Dantespino4D/Robot-sumo/PCBs/inferior/docs/inferior-PNG.png

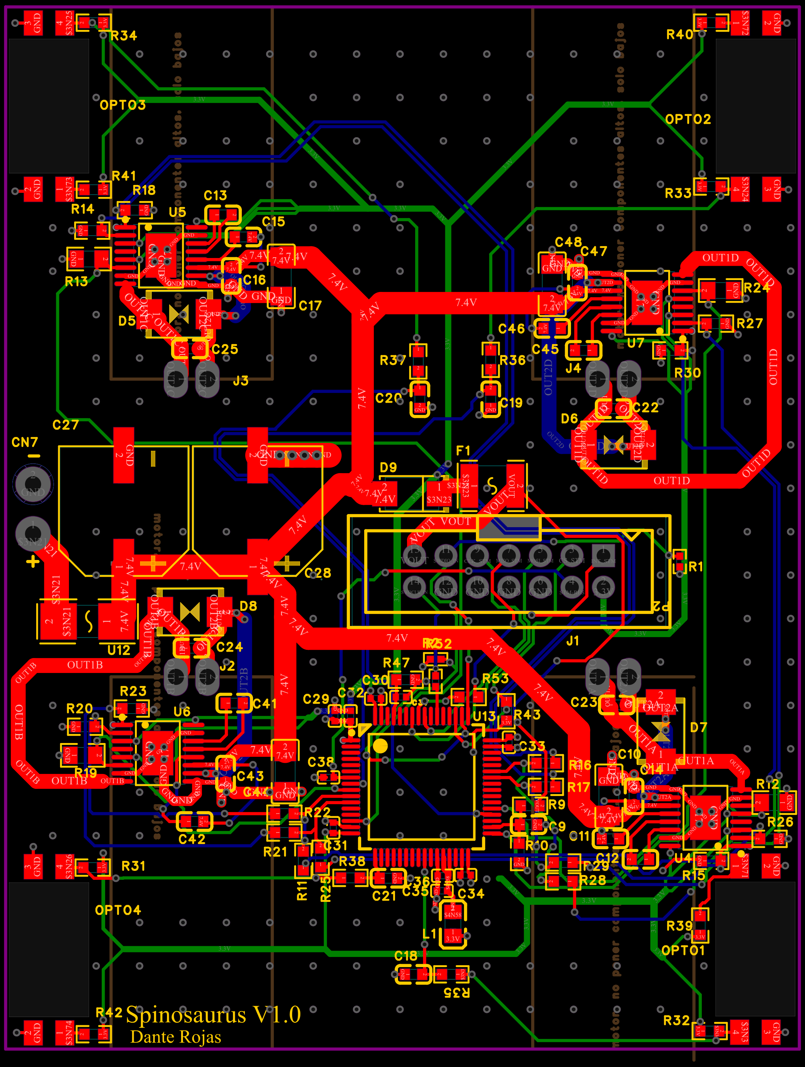
PCBs/inferior/docs/inferior-PNG.png
