Dantespino4D/Robot-sumo/PCBs/superior/docs/superior-PNG.png

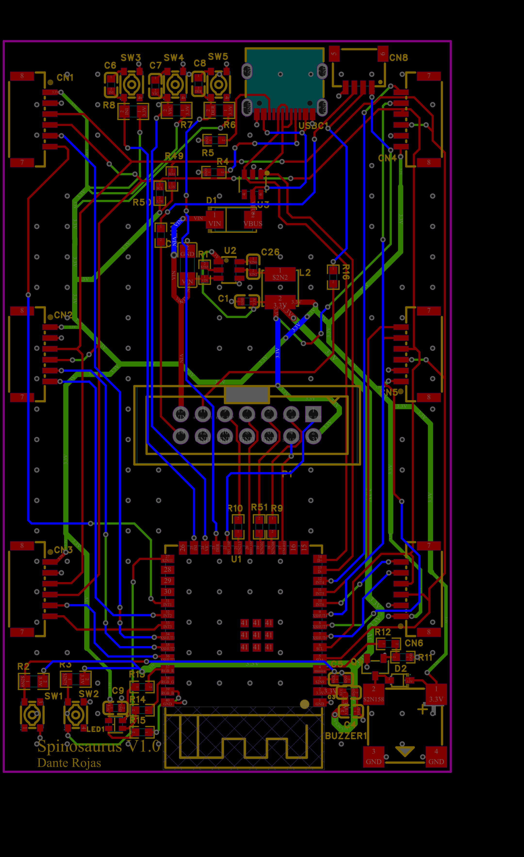
PCBs/superior/docs/superior-PNG.png
