Dantespino4D/Robot-sumo/PCBs/inferior/assembly/inferior-BOM.csv

No. | Quantity | Comment | Designator | Footprint | Value | Manufacturer Part | Manufacturer | Supplier Part | Supplier
1 | 13 | 100nF | C9,C11,C14,C15,C16,C22,C23,C24,C25,C42,C43,C46,C47 | C0603 |  | CC0603KRX7R9BB104 | YAGEO(国巨) | C14663 | LCSC
2 | 4 | 10uF | C10,C17,C44,C48 | C1206 |  | CL31B106KBHNNNE | SAMSUNG(三星) | C89632 | LCSC
3 | 4 | 47nF | C12,C13,C41,C45 | C0603 | 47nF | CL10B473KB8NNNC | SAMSUNG(三星) | C1622 | LCSC
4 | 4 | 10nF | C18,C19,C20,C21 | C0603 |  | 0603B103K500NT | FH(风华) | C57112 | LCSC
5 | 2 | 330uF | C27,C28 | CAP-SMD_BD10.0-L10.3-W10.3-LS11.0-FD |  | 25SVPF330M | PANASONIC(松下) | C48970627 | LCSC
6 | 1 | 4.7uF | C29 | C0402 | 4.7uF | CL05A475MP5NRNC | SAMSUNG(三星) | C23733 | LCSC
7 | 7 | 100nF | C30,C31,C32,C33,C34,C37,C38 | C0402 | 100nF | CL05B104KO5NNNC | SAMSUNG(三星) | C1525 | LCSC
8 | 1 | 1uF | C35 | C0402 | 1uF | CL05A105KA5NQNC | SAMSUNG(三星) | C52923 | LCSC
9 | 1 | 10nF | C36 | C0402 | 10nF | CL05B103KB5NNNC | SAMSUNG(三星) | C15195 | LCSC
10 | 1 | VH2-HEADER2 | CN7 | BAT_PIGTAIL_PADS_20AWG |  | VH2-Header2 | null | C9900011009 | LCSC
11 | 4 | SM6T15CA | D5,D6,D7,D8 | SMB_L4.6-W3.6-LS5.3-BI |  | SM6T15CA | ST(意法半导体) | C435927 | LCSC
12 | 1 | SS34 | D9 | SMA_L4.3-W2.6-LS5.2-RD |  | SS34 | MDD(辰达半导体) | C8678 | LCSC
13 | 1 | MF-MSMF150/24X-2 | F1 | F1812 |  | MF-MSMF150/24X-2 | BOURNS | C78695 | LCSC
14 | 4 | DB128L-5.08-2P | J1,J2,J3,J4 | PAD_MOTOR_2P_STRAIN_RELIEF |  | DB128L-5.08-2P-GN-S | DORABO(地博电气) | C395868 | LCSC
15 | 1 | GZ2012D101TF | L1 | L0805 |  | GZ2012D101TF | Sunlord(顺络) | C1015 | LCSC
16 | 4 | TCRT5000_C3271803 | OPTO1,OPTO2,OPTO3,OPTO4 | OPTO-TH_TCRT5000 |  | TCRT5000 | VISHAY(威世) | C3271803 | LCSC
17 | 1 | 2.54-2*7P简牛 | P2 | IDC-TH_14P-P2.54-V-R2-C7-S2.54 |  | 2.54-2*7P简牛 | BOOMELE(博穆精密) | C11215 | LCSC
18 | 2 | 10kΩ | R1,R2 | R0402 | 10kΩ | 0402WGF1002TCE | UNI-ROYAL(厚声) | C25744 | LCSC
19 | 1 | 3.3kΩ | R9 | R0603 |  | 0603WAF3301T5E | UNI-ROYAL(厚声) | C22978 | LCSC
20 | 1 | 1.5kΩ | R10 | R0603 |  | 0603WAF1501T5E | UNI-ROYAL(厚声) | C22843 | LCSC
21 | 8 | 330Ω | R11,R16,R17,R21,R22,R25,R28,R29 | R0603 |  | 0603WAF3300T5E | UNI-ROYAL(厚声) | C23138 | LCSC
22 | 4 | 1kΩ | R12,R13,R19,R24 | R0805 |  | 0805W8F1001T5E | UNI-ROYAL(厚声) | C17513 | LCSC
23 | 14 | 10kΩ | R14,R15,R18,R20,R23,R26,R27,R30,R31,R32,R33,R34,R43,R47 | R0603 |  | 0603WAF1002T5E | UNI-ROYAL(厚声) | C25804 | LCSC
24 | 4 | 1kΩ | R35,R36,R37,R38 | R0603 |  | 0603WAF1001T5E | UNI-ROYAL(厚声) | C21190 | LCSC
25 | 4 | 100Ω | R39,R40,R41,R42 | R0603 |  | 0603WAF1000T5E | UNI-ROYAL(厚声) | C22775 | LCSC
26 | 1 | 330Ω | R52 | R0402 | 330Ω | 0402WGF3300TCE | UNI-ROYAL(厚声) | C25104 | LCSC
27 | 1 | 33Ω | R53 | R0603 |  | 0603WAF330JT5E | UNI-ROYAL(厚声) | C23140 | LCSC
28 | 4 | DRV8874PWPR | U4,U5,U6,U7 | HTSSOP-16_L5.0-W4.4-P0.65-LS6.4-BL-EP |  | DRV8874PWPR | TI(德州仪器) | C1855818 | LCSC
29 | 1 | 2410FA-10A | U12 | FUSE-SMD_L6.1-W2.6 |  | 2410FA-10A | prosemi(普罗森美) | C2838934 | LCSC
30 | 1 | STM32G474RET6 | U13 | LQFP-64_L10.0-W10.0-P0.50-LS12.0-BL |  | STM32G474RET6 | ST(意法半导体) | C521608 | LCSC
