Dantespino4D/Robot-sumo/carcasa/piezas/stl/baseIntermedia.stl

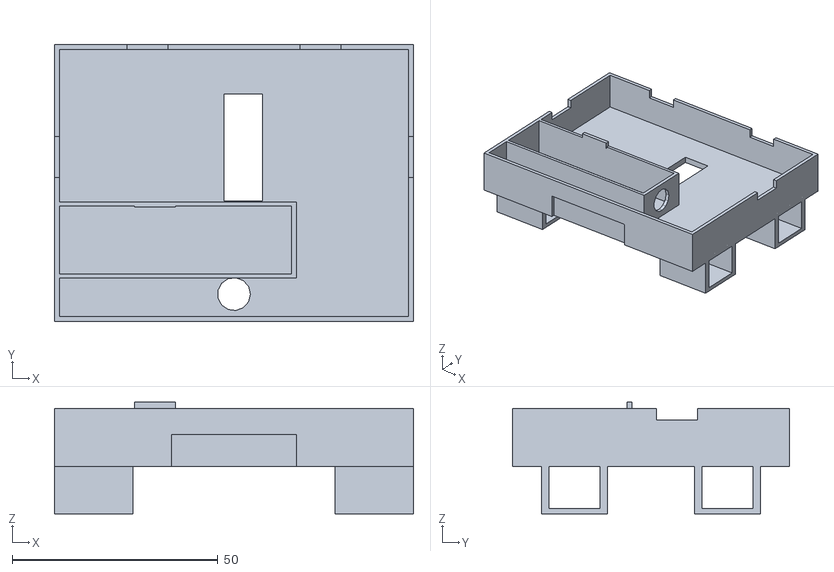
[picture p3: CAD file, 2026-11-11]
carcasa/piezas/stl/baseIntermedia.stl
87.2 x 67.2 x 27.1
