Dantespino4D/Robot-sumo/PCBs/inferior/3D/sumo-PCB-inferior.step

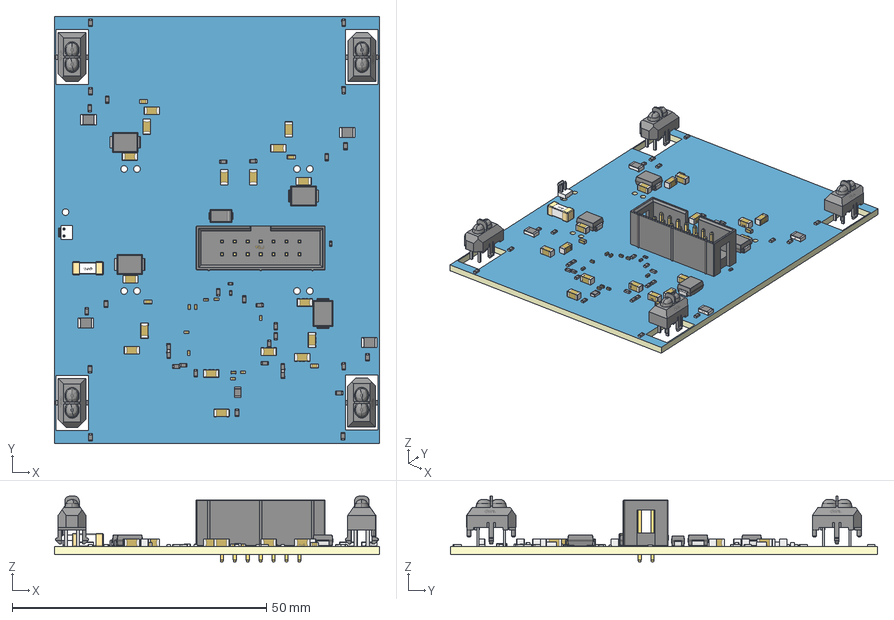
[picture p4: CAD file, 2026-10-07]
PCBs/inferior/3D/sumo-PCB-inferior.step
64.0 x 84.0 x 12.9 mm
Board~Igoe
TopCopper~Igoe
BottomCopper~Igoe
TopSilkscreen~Igoe
BottomSilkscreen~Igoe
TopFpcStiffener~Igoe
BottomFpcStiffener~Igoe
C0603~C0603~EXZm x 17
C0603~C0603_L1.6-W0.8-H0.8~EXZm x 4
R0603~R0603~OePm x 33
C0402~C0402_L1.0-W0.5-H0.5~cSQW x 10
R0402~R0402_L1.0-W0.5-H0.4~BnWU x 3
OPTO-TH_TCRT5000~OPTO-TH_TCRT5000~g6yf x 4
BAT_PIGTAIL_PADS_20AWG~CONN-TH_2P-P4.00_VH2-HEADER2~h32M
SMA_L4.3-W2.6-LS5.2-RD~SMA_L4.3-W2.6-LS5.2-RD~O7c9
IDC-TH_14P-P2.54-V-R2-C7-S2.54~IDC-TH_14P-P2.54-V-R2-C7-S2.54~8Vgt
R0805~R0805~fm0l x 4
L0805~R0805_L2.0-W1.3-H0.6~fm0l
SMB_L4.6-W3.6-LS5.3-BI~SMB_L4.6-W3.6-LS5.3-BI~sz2G x 4
FUSE-SMD_L6.1-W2.6~FUSE-SMD_L6.1-W2.6-H2.6~2nz7
