Dantespino4D/Robot-sumo/PCBs/superior/3D/sumo-PCB-superior.stl

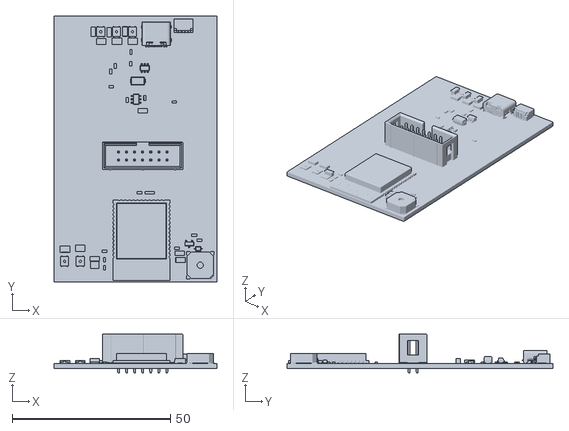
[picture p5: CAD file, 2026-11-07]
PCBs/superior/3D/sumo-PCB-superior.stl
51.4 x 84.0 x 12.2
