Dantespino4D/Robot-sumo/carcasa/piezas/stl/seguro.stl

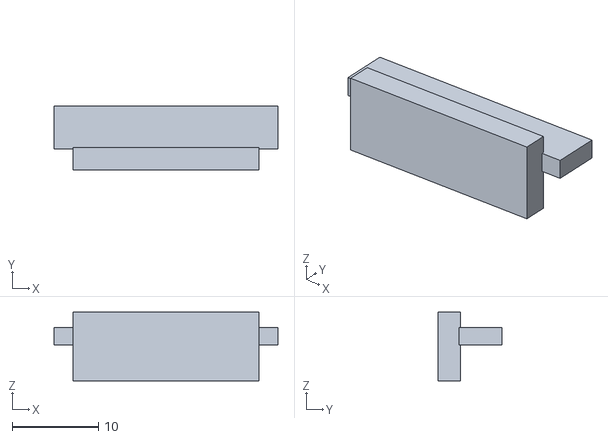
[picture p6: CAD file, 2026-11-11]
carcasa/piezas/stl/seguro.stl
26.0 x 7.40 x 8.00
