Dantespino4D/Robot-sumo/carcasa/piezas/stl/tapa.stl

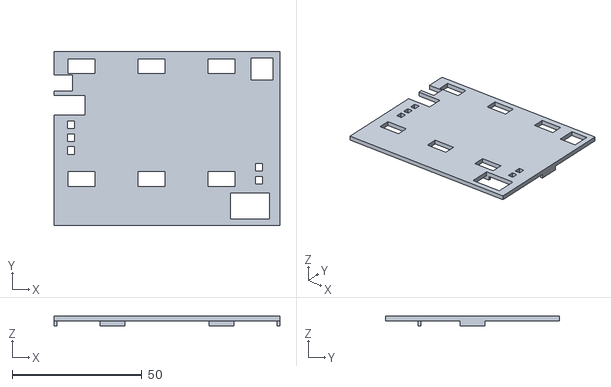
[picture p7: CAD file, 2026-11-11]
carcasa/piezas/stl/tapa.stl
87.2 x 67.2 x 3.90
