Dantespino4D/Robot-sumo/carcasa/piezas/stl/baseSuperior.stl

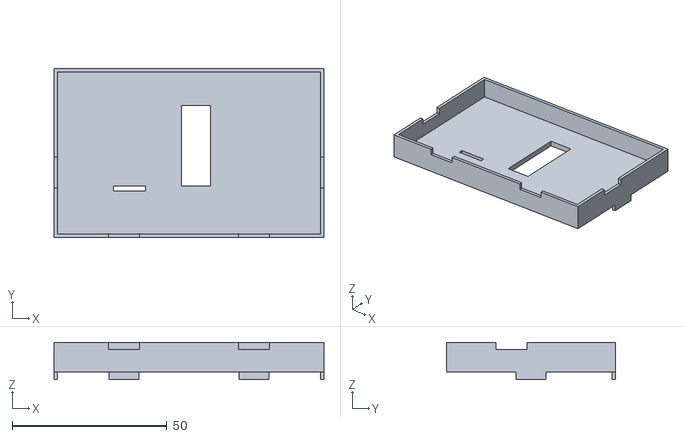
[picture p8: CAD file, 2026-11-11]
carcasa/piezas/stl/baseSuperior.stl
87.2 x 54.6 x 12.0
