Dantespino4D/Robot-sumo/carcasa/piezas/stl/base.stl

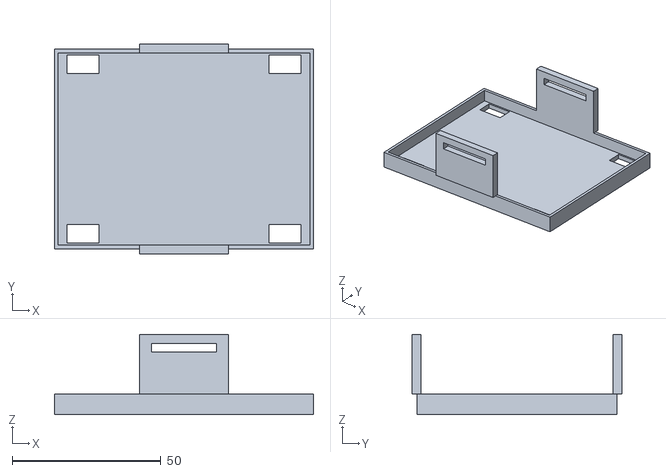
[picture p9: CAD file, 2026-11-11]
carcasa/piezas/stl/base.stl
87.2 x 70.6 x 27.0
