Dantespino4D/Robot-sumo/carcasa/piezas/base.scad

use <../carcasa-spinosaurus.scad>

base(84, 64, 0, 0, 5.5);
