Dantespino4D/Robot-sumo/carcasa/piezas/baseIntermedia.scad

use <../carcasa-spinosaurus.scad>

baseIntermedia(87.2, 67.2, 0, 0, 28.43);
