Dantespino4D/Robot-sumo/carcasa/piezas/baseSuperior.scad

use <../carcasa-spinosaurus.scad>

baseSuperior(87.2, 67.2, 0, 0, 40.21);
