Dantespino4D/Robot-sumo/carcasa/piezas/seguro.scad

use <../carcasa-spinosaurus.scad>

seguro(0, 32, 24.5, 0);
