Dantespino4D/Robot-sumo/carcasa/piezas/tapa.scad

use <../carcasa-spinosaurus.scad>

tapa(87.2, 67.2, 0, 0, 40.21);
