Dantespino4D/Robot-sumo/(list of files, cad)

Other CAD files:
PCBs/inferior/3D/sumo-PCB-inferior.stl
