Dantespino4D/Robot-sumo/PCBs/inferior/docs/inferior-Esquematico.pdf

7.4V

3.3V

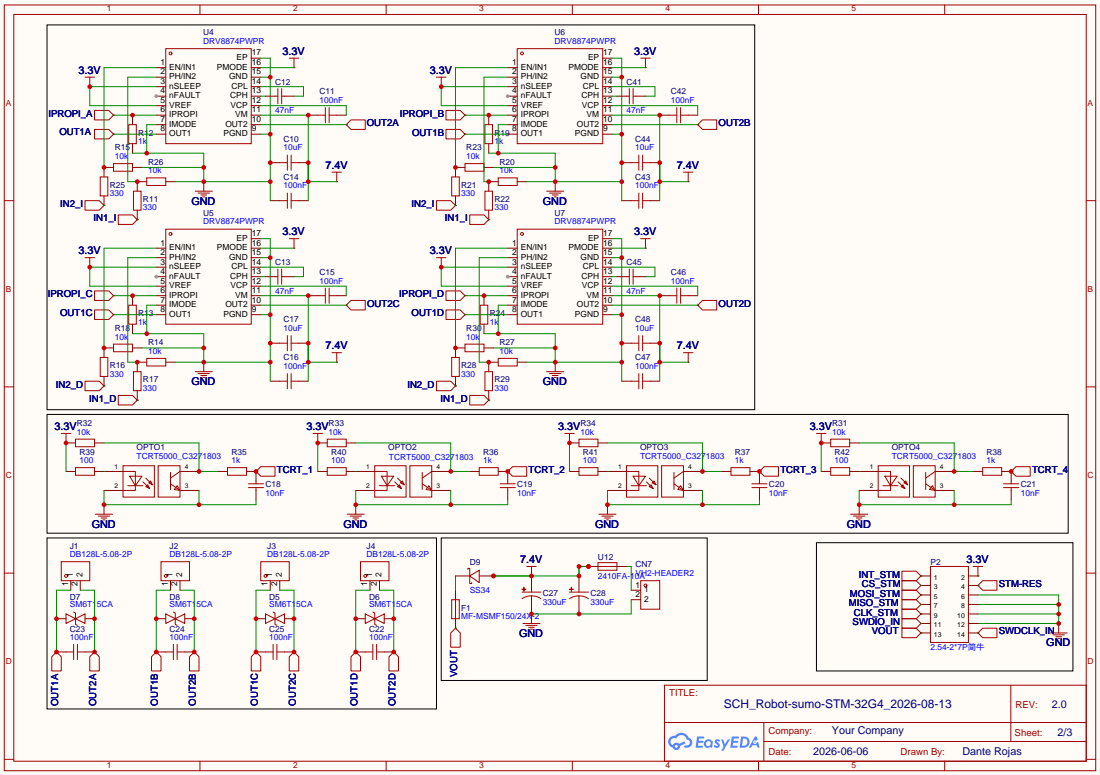
[picture p10: page 1]

DRV8874PWPR
OUT2 10 VM 11 VCP 12 CPH 13 CPL 14 GND 15 PMODE 16 EP 17

GND

3.3V

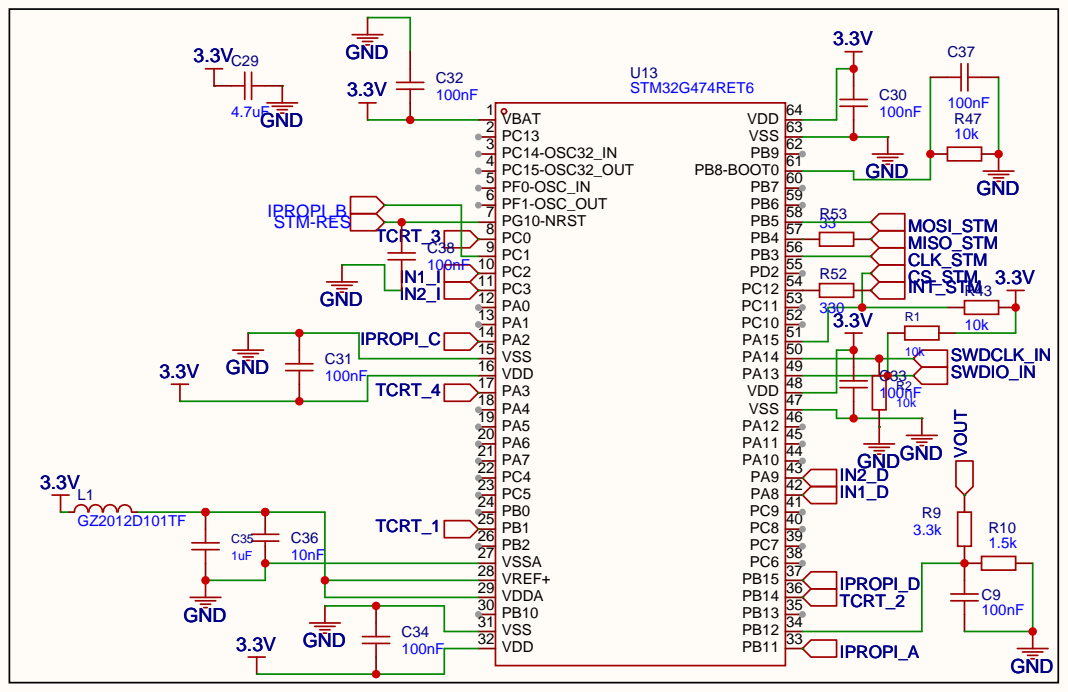
[picture p11: page 2]
