Dantespino4D/Robot-sumo/PCBs/superior/docs/superior-Esquematico.pdf

3.3V | 3.3V | 3.3V | 3.3V | 3.3V | 3.3V
GND | GND | GND GND | GND | GND SDA SCL | SDA SCL | SDA SCL | SDA SCL | SDA SCL | SDA

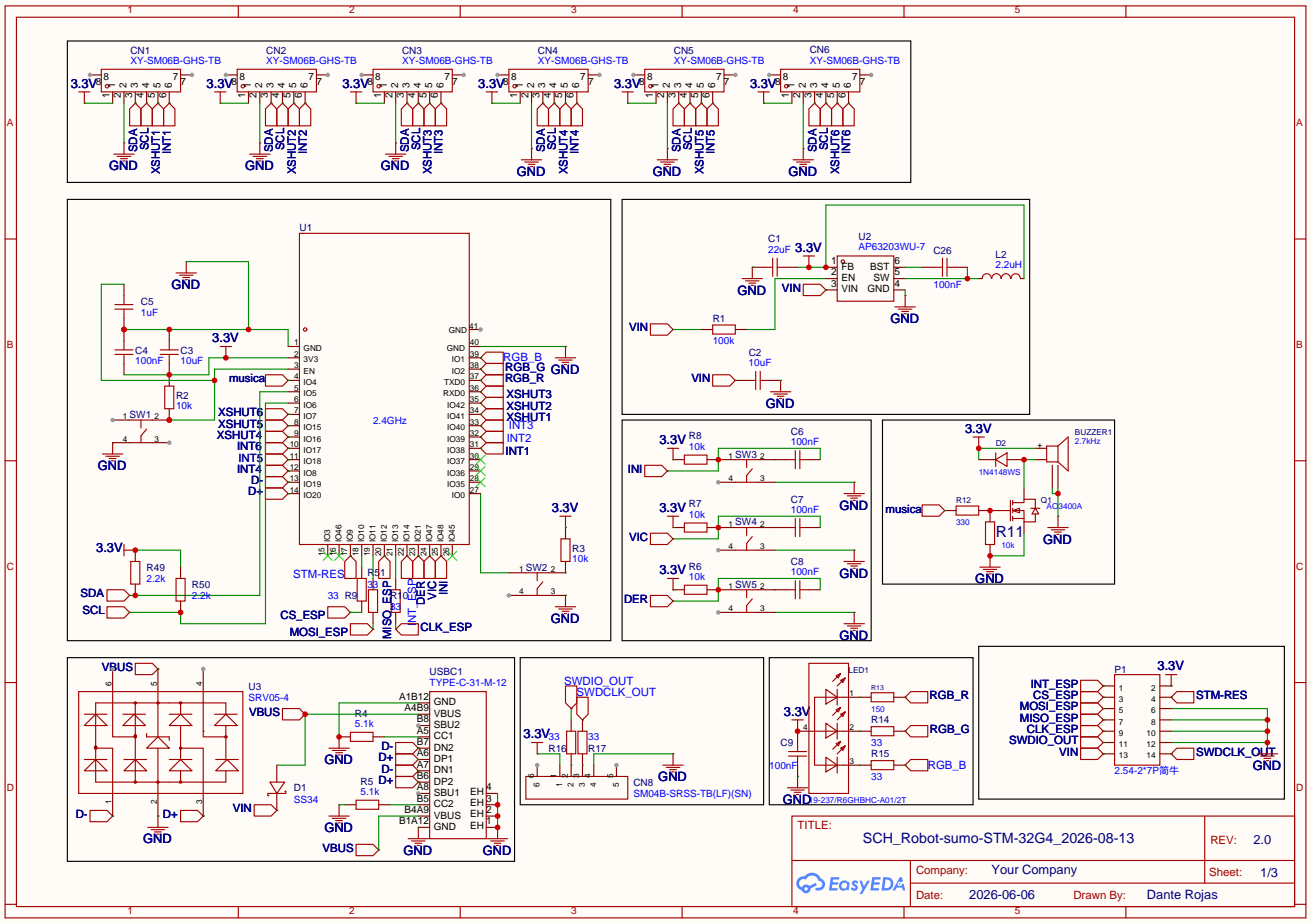
[picture p12: page 1]
