Dantespino4D/Robot-sumo/stm32g4/stm32g4.ioc

Mcu.UserName=STM32G474RETx
PA0.Signal=COMP3_INP
PA13.Signal=SYS_JTMS-SWDIO
PA14.Signal=SYS_JTCK-SWCLK
PA15.Signal=SPI1_NSS
PA2.Signal=ADC1_IN3
PA3.Signal=COMP2_INP
PA8.Signal=S_TIM1_CH1
PA9.Signal=S_TIM1_CH2
PB1.Signal=COMP1_INP
PB11.Signal=ADC2_IN14
PB12.Signal=ADC1_IN11
PB14.Signal=SharedAnalog_PB14
PB15.Signal=ADC2_IN15
PB3.Signal=SPI1_SCK
PB4.Signal=SPI1_MISO
PB5.Signal=SPI1_MOSI
PC0.Signal=ADC1_IN6
PC1.Signal=ADC1_IN7
PC12.Signal=GPXTI12
PC2.Signal=S_TIM1_CH3
PC3.Signal=S_TIM1_CH4
