Dantespino4D/Robot-sumo/esp32-s3/components/core/Estados.h

#ifndef ESTADOS_H
#define ESTADOS_H

enum Estado {
	ALTO,
	DIR_A,
	DIR_B,
	ATAQUE_AI,
	ATAQUE_BI,
	ATAQUE_AD,
	ATAQUE_BD,
	PRO_AI,
	PRO_BI,
	PRO_AD,
	PRO_BD,
	MAX_A,
	MAX_B,
	GIRO,
	ESTADOS
};

#endif // !ESTADOS_H
