Dantespino4D/Robot-sumo/(commit log)

2025-09-16 funcioones de los motores
2025-09-17 tarea del sensor de color
2025-09-20 sensor ultrasonico y puentes h funcionales al 100%
2025-09-20 logica 100% funcional(solo hace falta agregar el segundo sensor de color)
2025-09-21 sensores de color casi funcionales
2025-09-21 multiplexor I2C implementado(falta probarlo cuando lo compremos)
2025-09-21 funcion de calibracion agragada
2025-09-21 version que compila
2025-10-04 logica de la musica agragada(con adestes fideles)
2026-10-02 limpieza de memoria FIFO en SPI
    se limpio cualquier memoria residual en RX que haya quedado como
    resultado de haber abortado al transferencia previamente
2026-10-03 DMA no bloqueante
    se elimino unos portMAX_DELAY y se reemplazaron por 0 para no bloquear
    el programa durante las lecturas del SPI
2026-10-03 implementacion del AWD
    se implemento el AWD(Analog Watch Dog) para monitorear la corriente de
    los motores e implementar una maneabra de evasion
2026-10-03 delegacion completa de la maniobra de stall al stm32
    ahora el stm32 es el unico encargado de maniobrar en caso de stall se
    limpio cualquier referencia antigua de dicha maniobra, y se corrigieron
    bugs logicos antiguos
    [Estados.h, Estrategia1.cpp, Estrategia2.cpp, EstrategiaEstandar.cpp, MaquinaEstados.cpp, MaquinaEstados.h, Mqtt.cpp, Telemetria.cpp]
2026-10-03 pagina web local lista
    se implemento la pagina web local, añadiendo ademas de la confuguracion
    una visualizacion de la telemetria en tiempo real, la conexion con el
    codigo del robot no esta concluida
2026-10-03 pagina web local mejorada
    se mejoro la web local tanto en lo visual como en funcionalidad
    agregando nuevas funciones muy utiles
2026-10-04 telemetria completa en pagina web
    se actualizo la pagina web para mostrar toda la telemetria
2026-10-07 PCBs
    se agregaron los archivos de las PCBs, ademas de actualizar la
    telemetria de la pagina web(aun no conectada con el codigo del esp32)
    [inferior-BOM.csv, sumo-PCB-inferior.step, superior-BOM.csv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]
2026-11-07 carcasa
    se adjuntaro el archivo de la carcasa, asi como ligeros cambios en los
    archivos de la PCB y configuracion del .ioc
2026-11-11 primera version "lista" de la carcasa
    la carcasa esta tecnicamente lista aunque concarencias, pueds montar
    todo el circuito, pero no tiene rampas/cuñas, y los ToFs no tiene base
    donde apoyarse
2026-11-11 separacion en partes
    cada parte tiene su propio archivo, asi como su propio .stl para
    imprimirlas por separado
2026-11-11 correcciones carcasa
    se corrigio un error que dejaba los seguros separados en 2 piezas
